eivindpersonlig-design/DAC-And-Mic/doc/Dac ++.pptx

## Labprosjekt TFY 4030

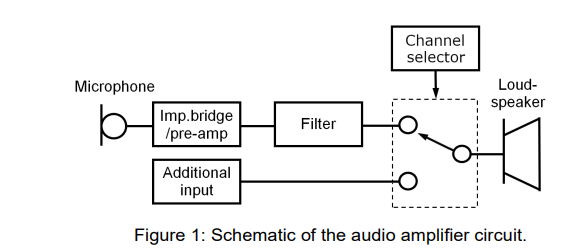
[picture p1: figure]

## Del 1- preamp (Impedance bridge)

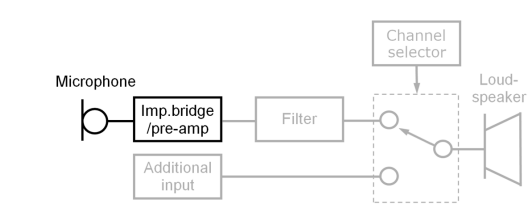
[picture p2: figure]

## Teori

- Mikrofon: Kondensator
  - Lydsignal → Elektrisk signal
P_(av) = 1/2VIcos(φ)
- Høyest mulig power factor: lavest mulig faseforskyvning φ
- Høy output impedans, lav input impedans

Notes: Med impedance bridging unngår vi signaltap grunnet faseuenighet

## Referansespenning

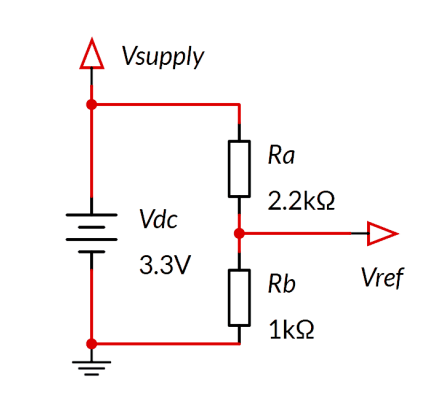
[picture p3: figure]

- 1 V

Notes: Lar signaler fluktuere rundt denne spenningen (1V) så vi ikke mister signal

## Mikrofon og “dummy mic”

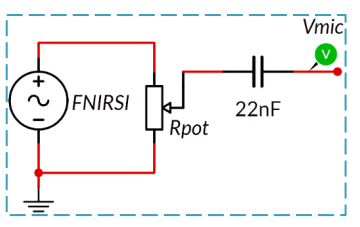
[picture p4: figure]
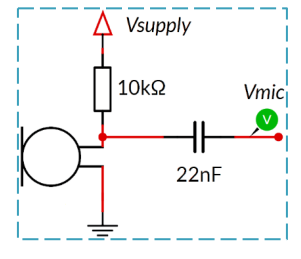
[picture p5: figure]

## Illustrasjon av preamp

Bytter med 100 kΩ for dummy mic

- G = 10 for mikrofon, 10 for dummy mic
- 15 mV → 1.5 V

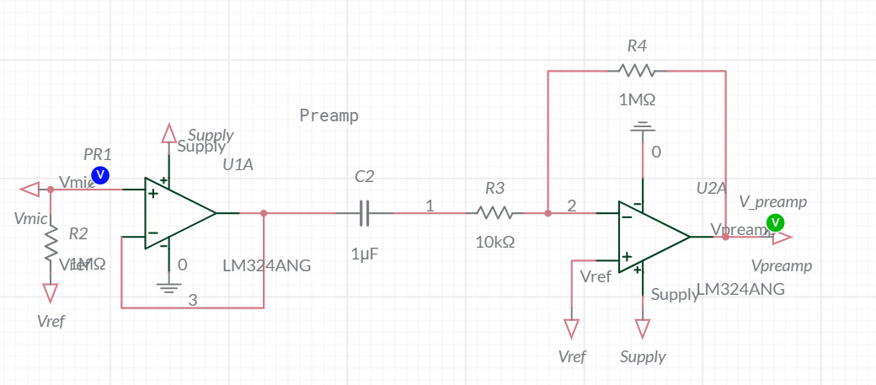
[picture p6: figure]

Notes: Vi må bytte resistor i amplifier når vi bytter mellom dummy mic og mic.
Pga Mic_out = 15mV som er lavere enn Oscilloscopet klarer å måle.
For å lettere feilsøke, teste OSV vlagte vi å ha Dmic_out = 150mV.
Jordet resistor hindrer (for) fluktuerende spenning
AC coupling som high pass filter

Vref:
DC-Biasing: R2 1(MOhm) er en bias-resistor som løfter inngangssignalet til Vref. Det oscillerer rundt Vref istedenfor GND
Hvorfor? Opampen kan ikke prosesere spenningssvingninger under 0.
Høy inngangsimpedans: R2 = 1MOhm for å minimere belastningseffekten på mikrofonen. Kondensatormikrofoner har høy utgangsimpedans; At R2 er såpass stor sikrer at spenningsfallet skjer over Opamp-inngangen, ikke i mikrofonen. (Forhindrer demping av signalstyrke)
Referansepotensial: R2 gir ingangen til Opampen en fast DC-referanse. Uten denne ville ingangen bias-strøm ladet opp interne kapasitanser helt til utganger går i metning mot en av forskyvningskildene
Kort oppsummert: R2 etablerer et stabilt arbeidspunkt for Opampen uten å degradere det svake mikrofonsignalet.

Buffer:
Gain = 1
«Impedanse transformator» Høy inngangs impedans (stjeler ingen strøm fra mikrofonen) og lav output impedans. Tilfører signalet mer strøm direkte fra strømforsyningen. Altså er det en «Strømforsterker»
Hvorfor: Sørger for at mikrofonen ikke blir belastet av resten av kretsen. Uten denne ville resten av kretsen «spist» det svake signalet
Negativ feedback: Holder signalet stabilt (konstant/likt)

AC-Coupling:
Effektivt et high-pass-filter, med lav cuttoff frekvens. Altså slipper den gjennom lyden, men sitter DC signalet (Vref)
Uten den ville vi også forsterket Vref i neste steg. Signalet hadde blitt mettet.

Inverting Amplifier:
Gain på 100 (Eller 10)
Inverterer signalet (Snudd 180 grader, ikke effekt på lyd)
Vref til + så det blir et virituelt jord-punkt. Lyden svinger rundt Vref ikke GND (HUSK: + input har i teorien uendelig impedans)
ALTSÅ!!! Amplifieren tar det svake renen signalet og pumper det opp med 100 ganger i styrke

## Bode plot

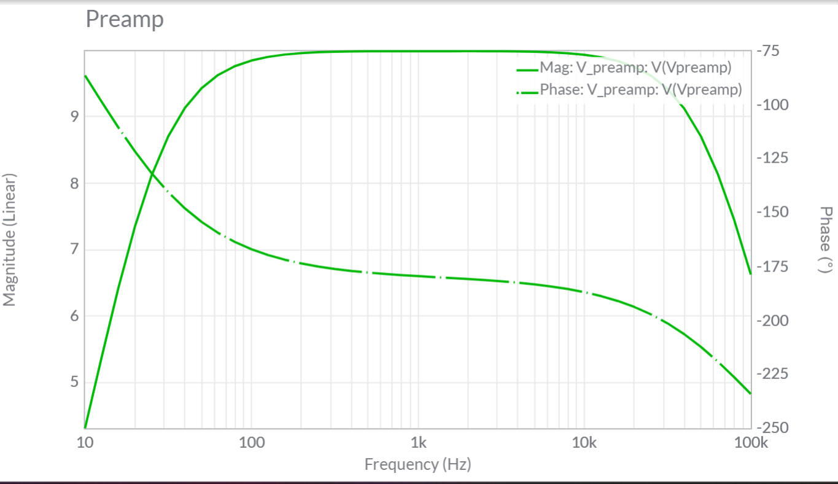
[picture p7: figure]

- Noterte spenning og Δt I Excel
- Plottet I python
- Formler:
  - Gain= (V_(out))/(V_(In))
  - φ=360^o ∙f∙Δt
- Opsettet får:
  - Svak Bass
  - Stor fase-skift for lyd

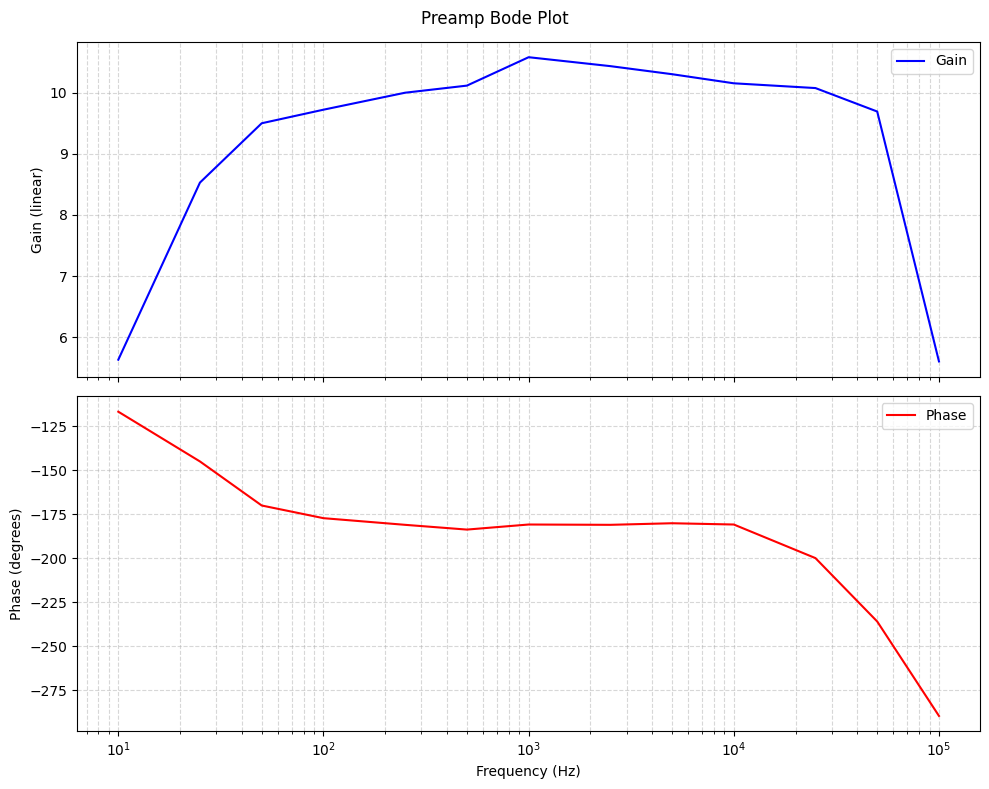
[picture p8: figure]

## Slide 8

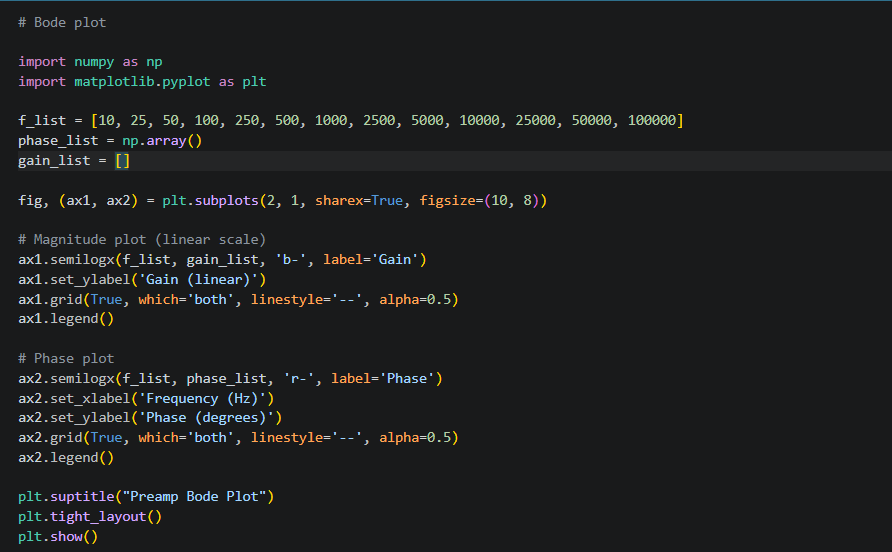
[picture p9: figure]
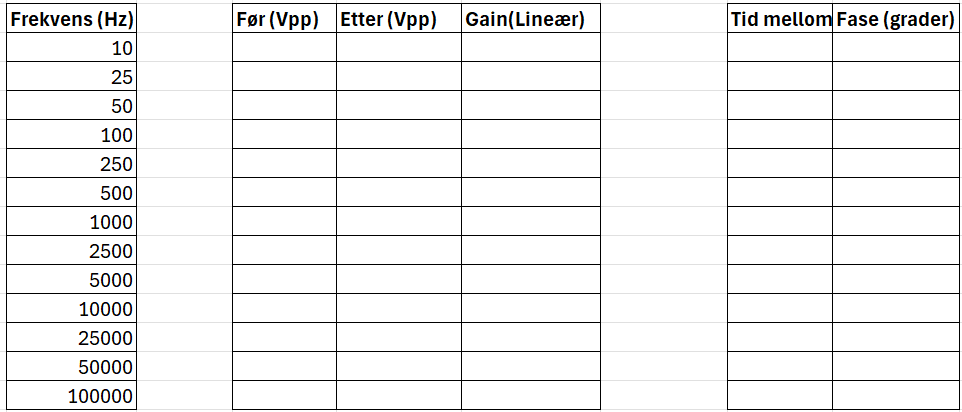
[picture p10: figure]

## Del 2 - Filter

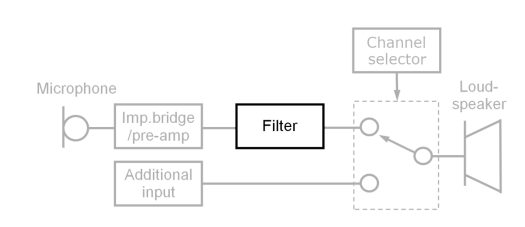
[picture p11: figure]

## Teori

- Sallen key-filter
f_c = 1/(2π√(Z_1 Z_2 Z_3 Z_4 ))
- Z_1 =Z_2 =Z_a og Z_3 =Z_4 =Z_b
→f_c =1/(2π√(Z_a^2 Z_b^2 ))=1/(2πZ_a Z_b) , Q= 1/2

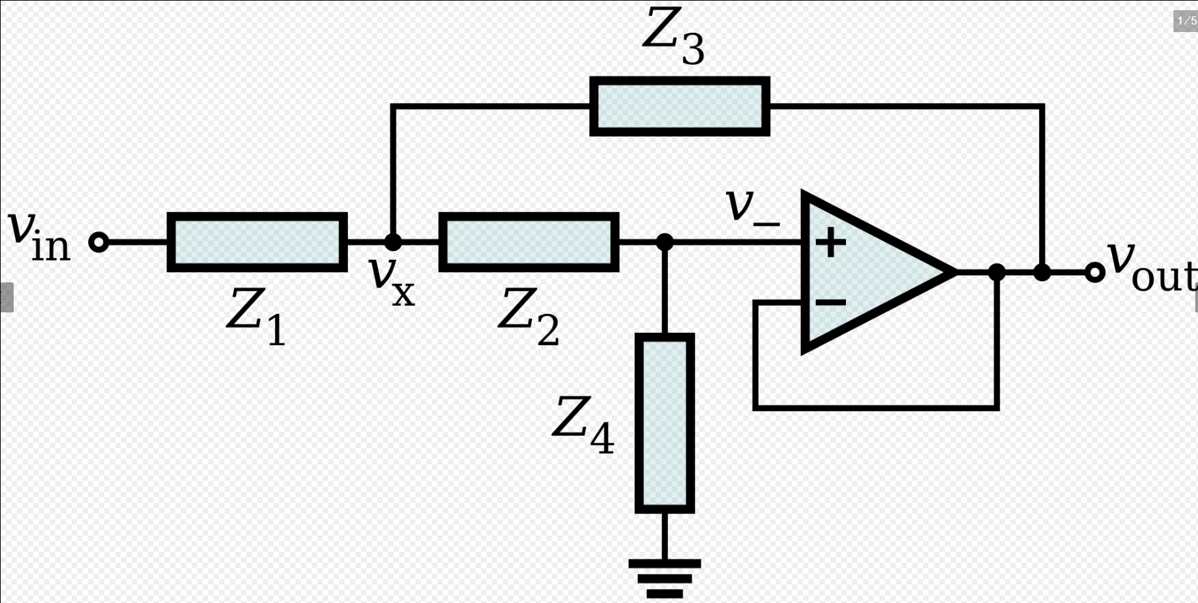
[picture p12: figure]

Notes: f_c er «half power point», der effekt er halvert
Q-faktor beskriver bredden på tillat intervall ift. frekvens

## High pass

- Z_a =C=2.2 nF
- Z_b =R=1 MΩ
- →f_c =1/(2πZ_a Z_b)=1/(2πRC)=72 Hz

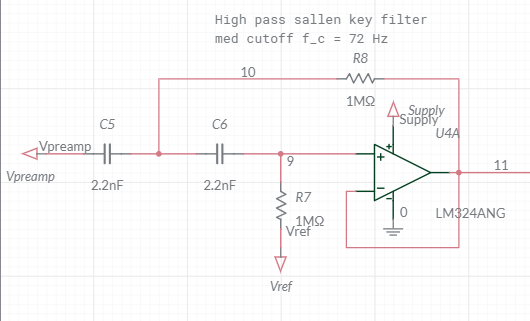
[picture p13: figure]

Notes: High pass:
Funksjon: Andre ordens filter (Dobbelt så effektivt for å fjerne uønsket støy utenfor cutoff frekvensen) Kondensatorene blokkerer DC og lave frekvenser, mens Resistorene «drar» lave frekvenser mot Vref
Vref? Vi bruker Vref for akuratt det samme som tidligere. Så vi ikke mister negative signaler. Drar også lavfrekvente signaler slik at de ikke slipper gjennom opampen

## Low pass filter

- Z_a =R=72 Ω
- Z_b =C=2.2 nF
- →f_c =1/(2πZ_a Z_b)= 1/(2πRC)=1063 Hz

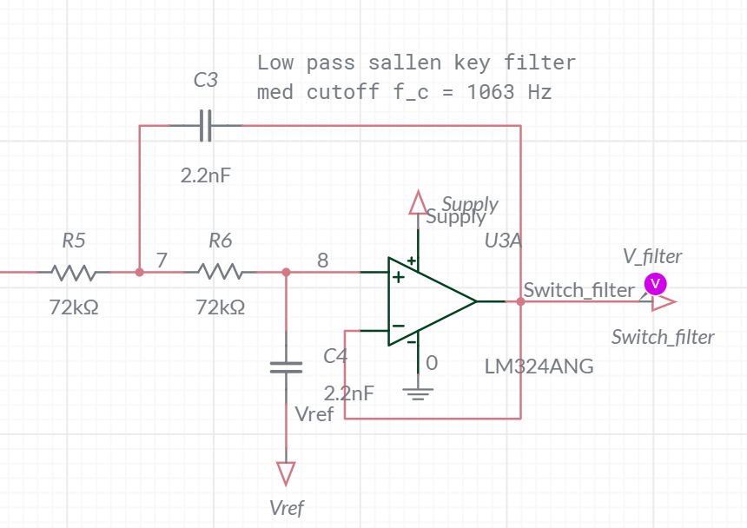
[picture p14: figure]

Notes: Low pass:
Funksjon: Resistorene slipper gjennom lave frekvenser, mens kondensatorene fungerer som «kortslutninger til Vref»/Utgang for høyfrekvente signaler. (Kortslutning i at signalene «velger» å gå gjennom C4 til Vref)
C3? Ved høye frekvenser er det en ledning som gir negaitv feedback. Hjelper å «Kanselere» de høyfrekvente signalene.

## Komplett filter

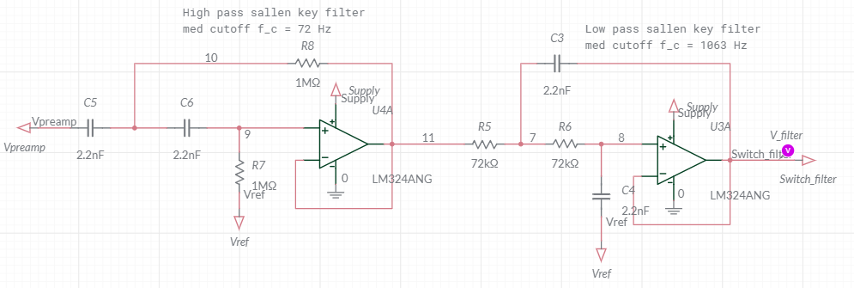
[picture p15: figure]

Notes: High-pass og Low-pass filterene danner til sammen et Band-pass-filter

## Bode plot

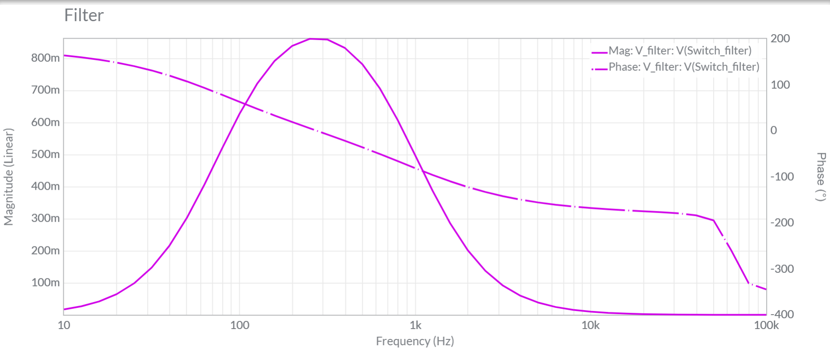
[picture p16: figure]

- Gain ≈0 når f>10 000Hz
- Hva betyr dette for lyden?
  - Svak Bass
  - Mannlige og litt dype kvinne stemmer vil høres godt, men kvaliteten vil ikke være på topp da de høye og lave tonene blir filtrert ut
  - (Høres ut som en gammel telefon)

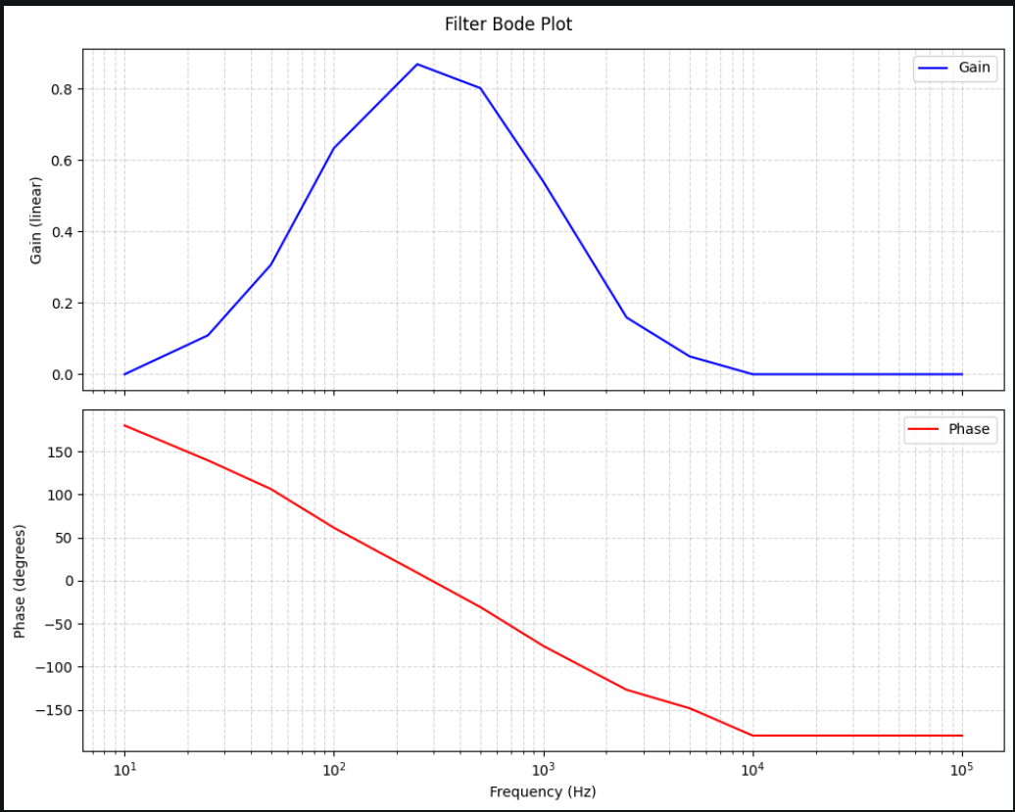
[picture p17: figure]

## Del 3 – DAC

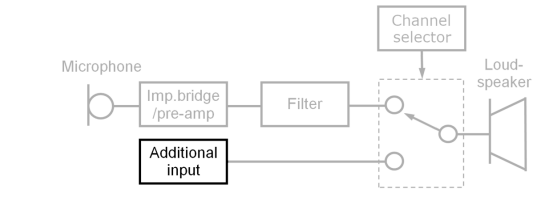
[picture p18: figure]

## Teori

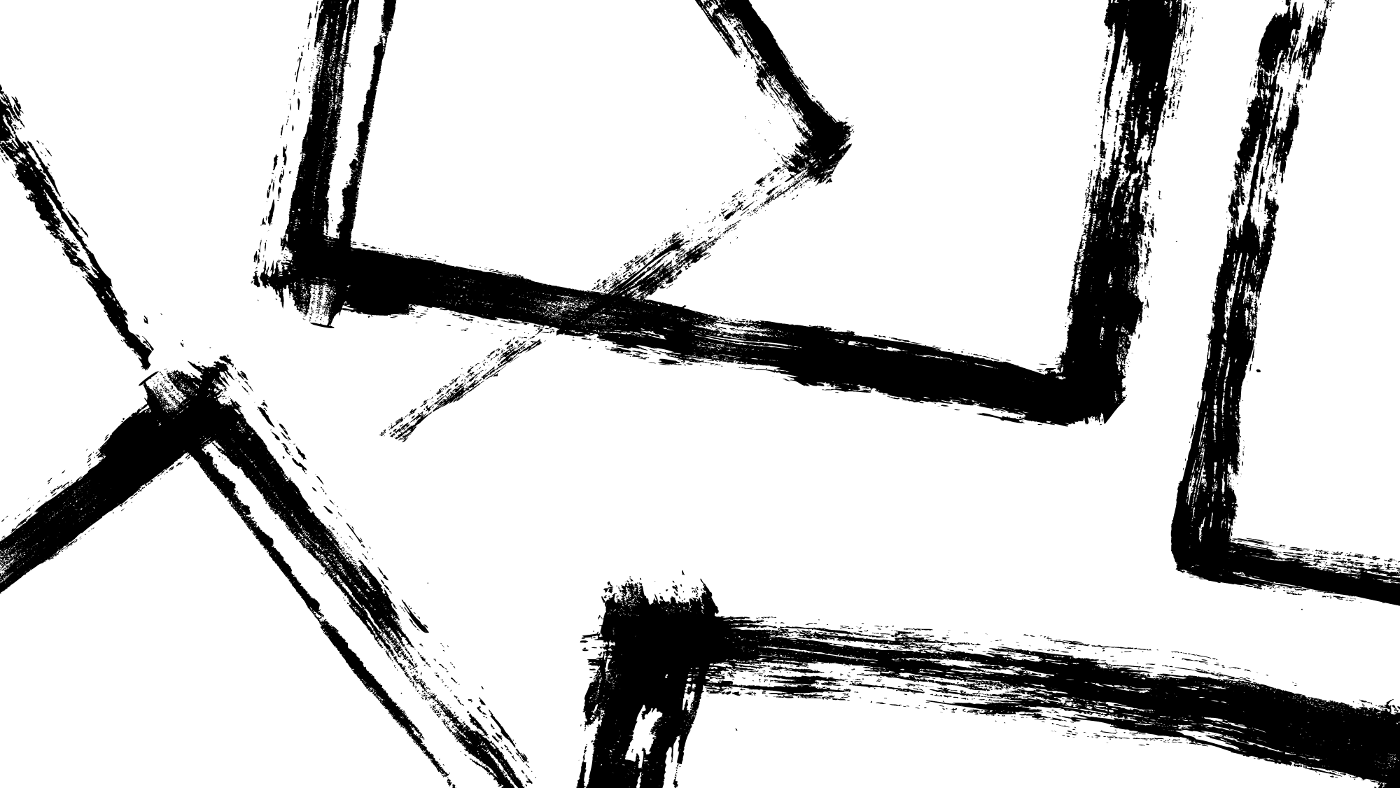
[picture p19: figure]

- Digitalt signal → Elektrisk signal (Digital to Analog Converter)
- Hver 2R ≈1bit. Formel:V_(ut) (i)=V_(supply) ∙D/(2^n) der D er binær input i base-10, n er stigens totale antall bits og i er portnummer. Nummerering starter med 0 fra ground
EKS:
  - V_(ut) (7)=(V_(supply))/2
  - V_(ut) (6)=(V_(supply))/4
  - V_(ut) (5)=(V_(supply))/8
…
  - V_(ut) (0)=(V_(supply))/256
- * Merk Om alle bits er satt til 1 er V_(out) =V_(Supply)
- R_(eq) =2R for hvert steg man går opp. V Halveres da for hver 2R man går opp, derad binært!

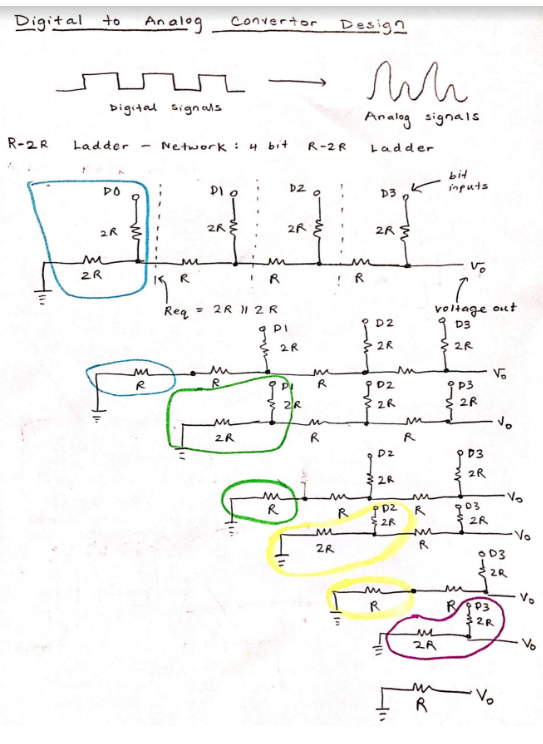
[picture p20: figure]

## R-2R ladder

Obs: Ikke perfekt R-2R
- R=10kΩ
- 2R=18kΩ

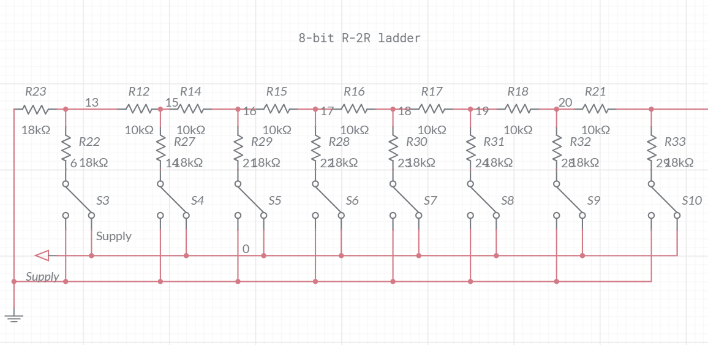
[picture p21: figure]

## High pass filter

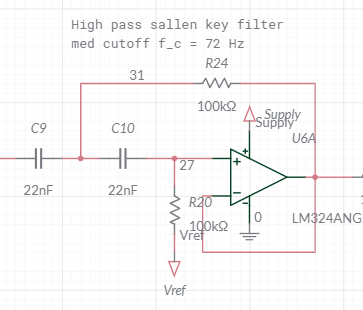
[picture p22: figure]

## Low pass filter

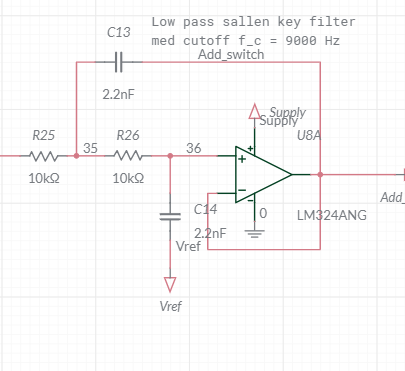
[picture p23: figure]

## Komplett DAC

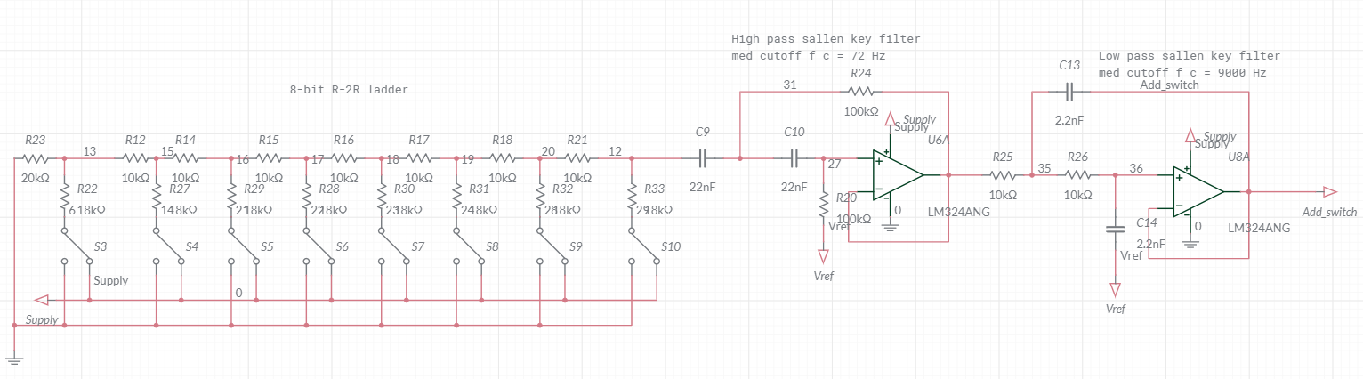
[picture p24: figure]

## Kode til DAC (Python)

Konverterer wav til header

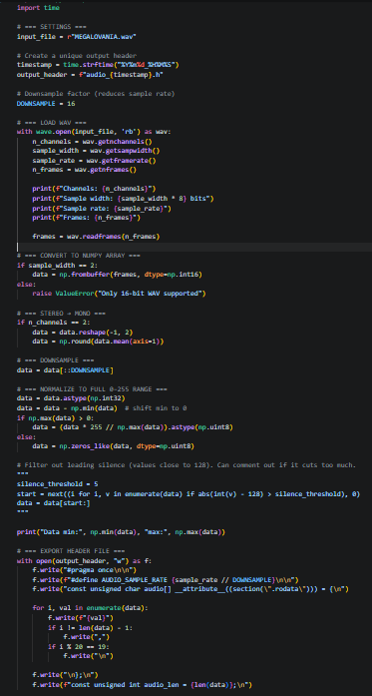
[picture p25: figure]

## FUNGERER DEN???

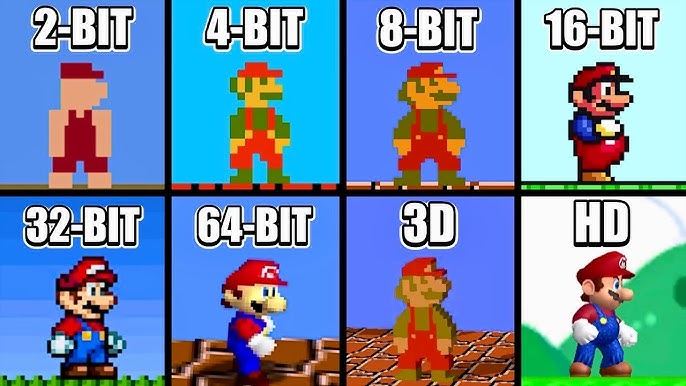
[picture p26: figure]
Super Mario Bros. 2-BIT vs 4-BIT vs 8-BIT vs 16-BIT vs 32-BIT vs 64-BIT vs 3D vs HD

## Del 4 – Channel selector

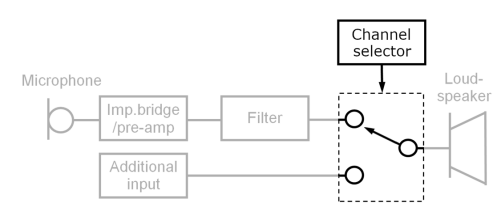
[picture p27: figure]

## Teori

- Non-inverting summing amplifier
  - Gir ut den positive summen av inputsignalene
  - Outputfase ≈ inputfase
- Parasitt-kapasitans
  - Uønsket capacitance som lekker gjennom

## Illustrasjon av kanalvelger

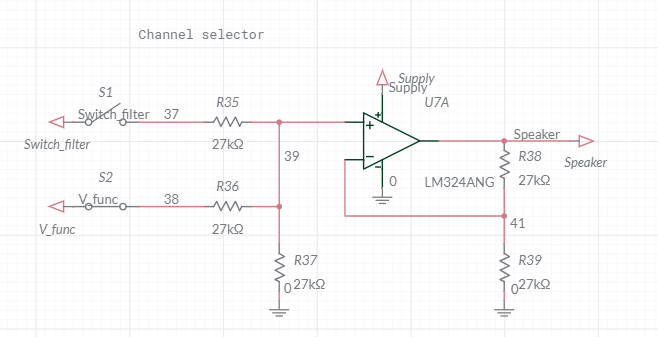
[picture p28: figure]

Notes: Feedback
Valgte 22kOhm da 1kOhm førte til at lyd begynte å lekke, men høyere ga ekstra støy

## Slide 26

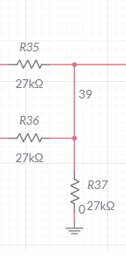
[picture p29: figure]

Input for begge kanalene

Hvorfor?
- non-inverting summing amplifier ≠adder (Rein)
- Finner et vektet gjennomsnitt av innputtene.
  - Effektivt sett er det en spenningsdeler mellom:
    - Input 1,
    - Input 2
    - Ground.

Gir det mening numerisk?
En kanal lukket:
- V= (V_(Gnd) +V_(in))/2= (0+100.15mV)/2=50.075mV
- V_(out) =Gain∗V=100.15mV
To kanaler lukket:
- V= (V_(Gnd) +V_(in1) +V_(in2))/3= (0+100.15mV+100.15mV)/3=66.767mV
- V_(out) =Gain∗V=2∗66.767mV=133.53mV

Output 1 kanal lukket

Output begge kanalene lukket

G=1+(R_38)/(R_39)=1+1=2

## Kilder?

- Agarwal, T. (2024, July 5). Non Inverting Summing Amplifier : Circuit, Derivation & Its Uses. ElProCus - Electronic Projects for Engineering Students. https://www.elprocus.com/non-inverting-summing-amplifier/
- Freedman, R.A., Young, H.D. (2020). University Physics with Modern Physics (15th Edition, Volume 2). Pearson Education.
- Storey, N. (2017). Electronics: a systems approach (Sixth Edition). Pearson Education.
- Wikipedia, The Free Encyclopedia. (hentet 2026, 11. mars). Impedance bridging. https://en.wikipedia.org/w/index.php?title=Impedance_bridging&oldid=1272875694
- Wikipedia, The Free Encyclopedia. (hentet 2026, 11. mars). Microphone. https://en.wikipedia.org/w/index.php?title=Microphone&oldid=1340028654
- Wikipedia, The Free Encyclopedia. (Hentet 2026, 9. april). Sallen-Key topology. https://en.wikipedia.org/wiki/Sallen– (https://en.wikipedia.org/wiki/Sallen–Key_topology)Key_topology (https://en.wikipedia.org/wiki/Sallen–Key_topology)
- https://www.multisim.com/content/ntUwHpaAN2kbpAUV8E6jkY/mikrofonkrets-bra-1/open/

## HVORDAN FUNGERER MIC??????

Kondensator versjon som vi bruker har en parallell plate kondensator i seg som består av en fast plate og en membran som vibrerer med lydbølgene. Det gjør at avstanden mellom platene endrer seg.
Vi vet at ΔV= Q/(ΔC) der ΔC=εA/(Δd) Altså er ΔV ∝ 1/(Δd) der d er
avstanden mellom membranen og den faste platen og V er spenningen over kondensatoren.

## HVORFOR ER IKKE CHANNEL SELECTOR EN REIN SUM??????

- Begge knapper lukket:
  - non-inverting summing amplifier er ikke en rein adder
    - Oppfører seg som spenningsdeler «Vektet gjennomsnitt»
    - Gain = 2
